lapin06/HT2018/README.md

<h1>Color Rabbit Prediction - FAURE Héloise & LEMAIRE Théo</h1>

<h4>-------------------------------------------Le lapin mentaliste qui prédit vos choix--------------------------------------------</h4>
  </p>
  
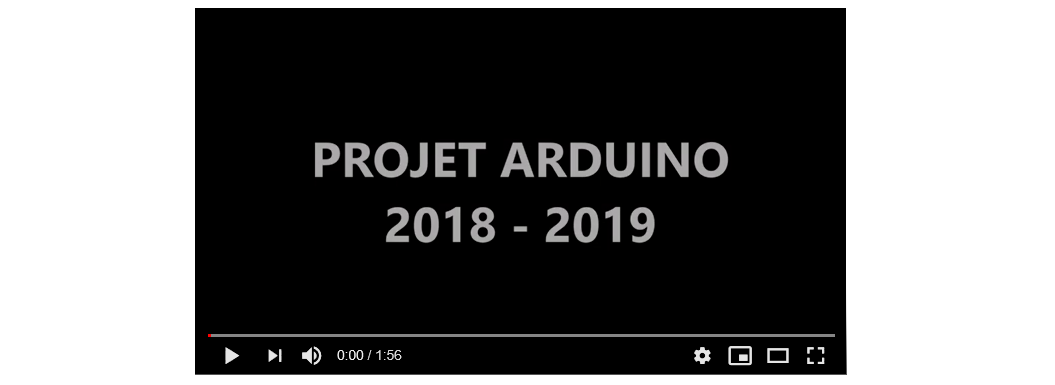
[picture p1: Ressources/video.PNG]
  
  <a href=https://www.youtube.com/watch?v=MNZIZz9GOWQ> ==================================>  LIEN VIDEO <=================================== </p> </a></p>
<p>-------------------------------------------------------Bande annonce ----------------------------------------------------------------</p>

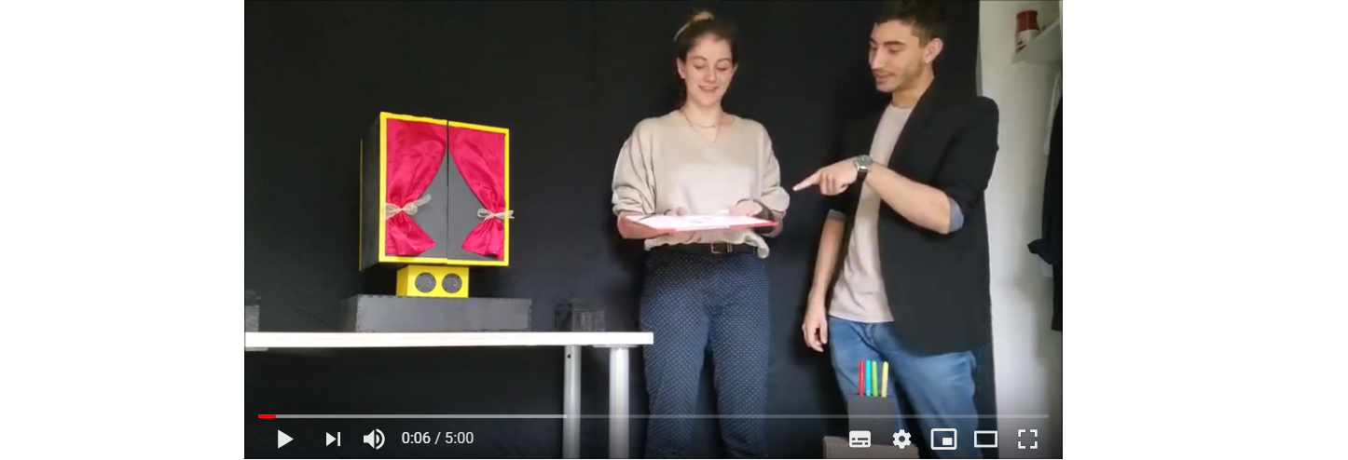
[picture p2: Ressources/Oral2.png]

<a href=https://www.youtube.com/watch?v=OcY4DatY3gI> ==================================>  LIEN VIDEO <=================================== </p> </a></p>

<p>-------------------------------------------------Démonstration en 5 minutes ---------------------------------------------------------</p>

<h3>  1. Sommaire : </h3>
<ul>
  <li><h4> Documents </h4>
    <ul><li>planning du projet: mit à jour toutes les semaines, concernant notre avancement dans le projet ( si nous avons respecté le planning)</li></ul>
    <ul><li>le cahier des charges, de notre Création Color Rabbit Prédiction</li></ul>
    <ul><li> Scripte du lapin</li></ul>
    <ul><li> Enregistrements</li></ul></li>
  
  <li><h4> Les Rapports de séances</h4>
  <ul><li>Rapport - Heloise</li></ul>
  <ul><li>Rapport - Théo </li></ul>
    <p> Dans ce répertoire vous pourrez suivre notre progression grâce au rapports de séances rédigés chacun par un des membres du binôme</p></li>
  
  <li><h4> Ressources </h4>
   <p> Dans les ressources vous pouvez avoir acces aux différents images (ou autres) qui apparaitront dans les rapports de séances </p>
    
  <li><h4> CODE </h4>
  <ul> <li>1.Boite à feutre </li></ul>
  <ul><li> 2.Boite à lapin </li></ul>
    <ul><li> 3.Test composants </li></ul>
  </li>
  </ul>
  <br/>
  
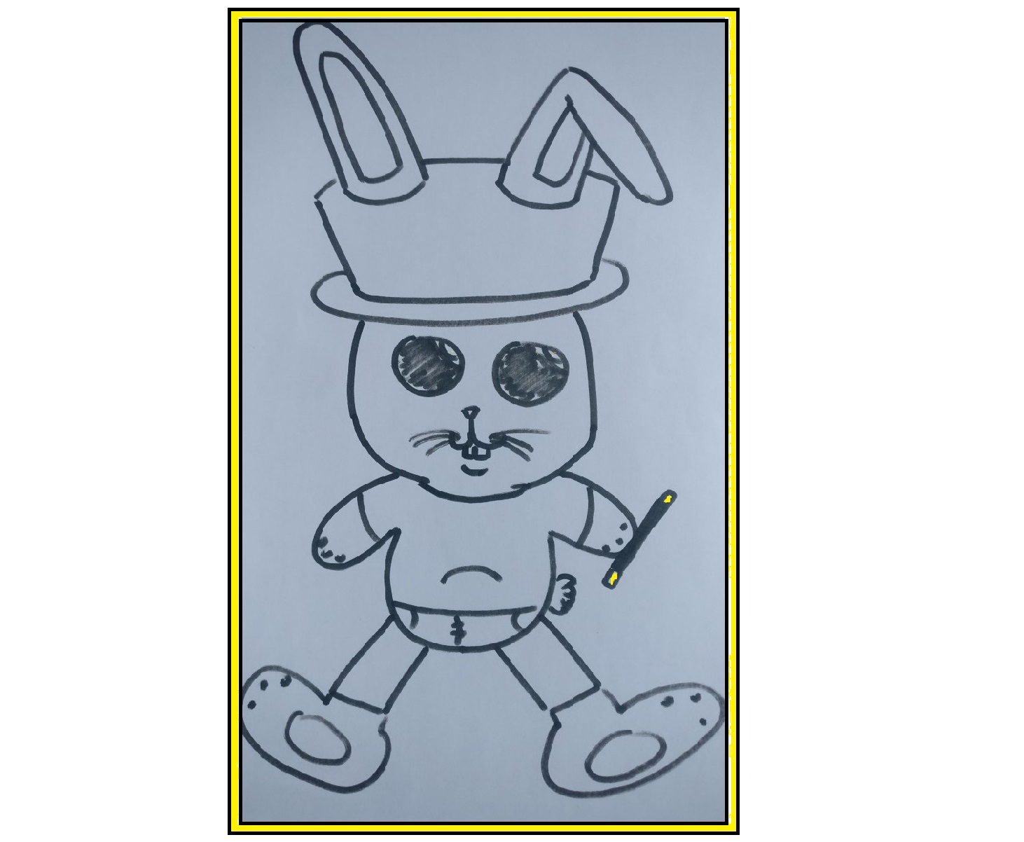
[picture p3: Ressources/20-3.jpg]
  

<h3> 2. L'histoire : </h3>
<p> Inspiré du tour original color pen prediction , proposé par la société americain murphys magic et vendu à l'échelle mondiale. Un veritable Best Seller depuis 5 ans , nous allons vous proposer ici notre version de ce tour, Le color rabbit prediction! Nous proposons ici un version ou le magicien ne fait aucune action sur le tour, tout est fait par une petite pelucche (le lapin). Ceci permetd d'avoir de nombreux avantages, permettant de transformer une prestation d'un magicien seul pour passer a un duo plein de folie. Pour d'avantage d'explication nous vous invitons a consulter notre cahier des charges </p> 
