lapin06/HT2018/Rapports de séances/Rapports - Héloise.md

<h1>Séance 1 : 10/12/18 : Début du projet</h1>
<h2> Aujourd'hui nous avons démarré notre projet qui s'intitule "Color Rabbit prediction"</h2>
 <li>
  <ul><h3> Organisation du travail </h3></ul>
     <p>Nous avons découpé les étapes du projet en fonction des séances, pour cela nous nous sommes mis d'accord pour un planning que j'ai ensuite réalisé. Cela m'a prit la moitié de la séance car il est difficile de prévoir le temps que l'on mettra pour chaque étape du code et de la construction, ce planning sera disponible dans /HT2018 </p>
 
 <ul><h3>Cahier des charges</h3></ul>
  <p>Ensuite j'ai réalisé le cahier des charges correspondant au projet, celui-ci sera aussi disponible dans le répertoire principal (temps: 1h15) </p>
  
  <ul><h3> Communication Arduino </h3></ul>
  <p>Dans la dernière demi heure j'ai commencé à faire des recherches sur comment faire parler une carte Arduino, ce qui est une grande partie de notre projet. j'ai trouvé assez rapidement le code relatif à cela, mais pour le réaliser il faut importer la librairie tolkiez, j'ai alors rencontré un problème de compilation avec cette librairie. je résoudrai surement ce problème chez moi ou la séance suivante. L'idée est la suivante: le Lapin et en fait celui qui va parler tout le long du tour ( ce tour n'a pas besoin de d'interactions avec nous pour fonctionner), cela implique qu'il devra lui même désigner quels parties colorier, il dira bonjour etc... </p>
  </li>

<h1>Séance 2 : 17/12/18 : communication arduino avec Sparkfun Voice box shield</h1>
<li>
<ul><h3> Utilisation de Sparkfun Voicebox Shield </h3>
<p> J'ai abandoné l'idée d'utiliser la librairie tolkiez.h qui est une librairie permettant d'écrire un code pour faire parler la carte Arduino avec l'aide d'un haut parleur. En effet je n'arrivais pas à résoudre les problèmes de compilation.

Je suis donc passer au Sparkfun Voicebox qui est composé d'une carte voiceBox, d'une carte arduino et d'un haut parleur. Le but étant de pouvoir faire parler notre lapin avec ce haut parleur, avec lequel on peut mettre une carte mémoire qui va pouvoir mémoriser ce que notre lapin va dire. On a donc besoin de la librairie "software serial" pour parler au SpeakJet (voiceBox). J'ai donc commencer mes recherches et j'ai pu trouver un github qui explique comment se servir de ce voicebox, accompagné d'un code. </p>

<h4> problème de compilation </h4>
<p> J'ai téléchargé le code et j'ai passé du temps à comprendre les différents points de cette voicebox ( par exemple les sorties/entrées RST, RDY,SPK), et à comprendre comment cabler tout cela(nous avions déjà en stock le matériel).
Je me suis ensuite retrouvé face à un problème de compilation de nouveau, cette fois j'ai réussi à comprendre ce problème et j'ai donc cherché une solution. PROBLEME: "narrowing conversion of '200' from 'int' to 'char' inside { }" char permet de prendre des nombres en 7bit (et permet de mettre un signe devant) or dans ma chaine de caractère j'ai des nombres en 8bit ( tous les nombres >=100) j'ai donc trouvé la solution en mettant devant char : unsigned , cela permet d'enlever le bit réservé au signe, donc char est dorénavant en 8bit et peut aller jusqu'a 255. </p>

<p> mais ce n'était pas le seul soucis... en effet je n'arrivais toujours pas à compiler mon programme, alors que sur l'ordinateur de mon binôme , la compilation se faisait sans erreur. j'ai pu résoudre ce problème en téléchargeant la version la plus récente d'Arduino. j'ai testé mon programme en faisant dire à la carte " hello " . Cela fonctionne! </p>

<p> Tout ce temps passé à essayer de résoudre les problèmes de compilation et à re-télécharger Arduino m'a fait perdre un temps précieux. Cependant aillant réussi à faire fonctionner le haut parleur, je pourrai rattraper tout ce temps pendant les vacances en écrivant le code pour faire parler arduino ( un code qu'il faut travailler car chaque lettre ou syllabe est codé d'une manière spéciale, et qui plus est, en anglais) . </p>

<h4> je vous invite à aller voir la vidéo où Spark nous dit bonjour, en clickant sur le lien suivant: <a href="https://www.youtube.com/watch?v=zQq6gc-LgdA"/> Sparkfun hello </h4> </li>

<h1>Travail 1 (hors Séances) : 21/12/18 : Sparkfun et boite des feutres</h1>
<li>
 <ul><h3> Approndissement de la librairie Sparkfun </h3></ul>
 <p> Aujourd'hui je me suis un peu plus penché sur la librairie Sparkfun pour pouvoir comprendre vraiment comment cela fonctionne et pour commencer à coder des phrases en anglais par moi même. Je me suis confrontée à plusieurs soucis, dont le plus gros et que, ce que dis notre carte Arduino et particulèrement inaudible quand on ne connait pas la phrase en anglais... Il faut donc que je cherche si Sparkfun permet aussi de modifier la voix pour éviter cette voix robotique trop métalisée. Le deuxième soucis et que le code permet de coder des prononciations et pas des syllabes, j'ai passé donc énormément de temps pour simplement lui faire dire "Rabbit" (=lapin) car il fallait trouver le code relatif aux lettres ou sons, puis ensuite trouver le code chiffré correspondant. En aillant écrite toutes les phrases que notre arduino doit dire, on s'est rendu compte que cela aller me prendre un temps considérable pour tout coder et d'autant plus que cela sera à peine compréhensible. On se retrouve donc face à une impasse. 
Nous avons pensé à une possibilité et nous demanderont la faisabilité de celle-ci par mail:
   Enregistrer nous même nos voix car nous avons la possiblité de mettre une carte mémoire sur Sparkfun. </p>

 <ul><h3> Schema de la boite de feutre </h3></ul>  
 <p> Aujourd'hui nous avons pris la décision de faire la maquette de la boite de feutre étant donné que le code des capteurs était fait.
 Nous avons donc réalisé deux schémas car nous ne savions pas si nous devions faire une boite ronde ou carré ( l'avantage de la boite ronde était que celle-ci faisait plus naturellement pot de feutre). Vous pouvez voir les schemas ci-dessous avec les dimensions prises:
 
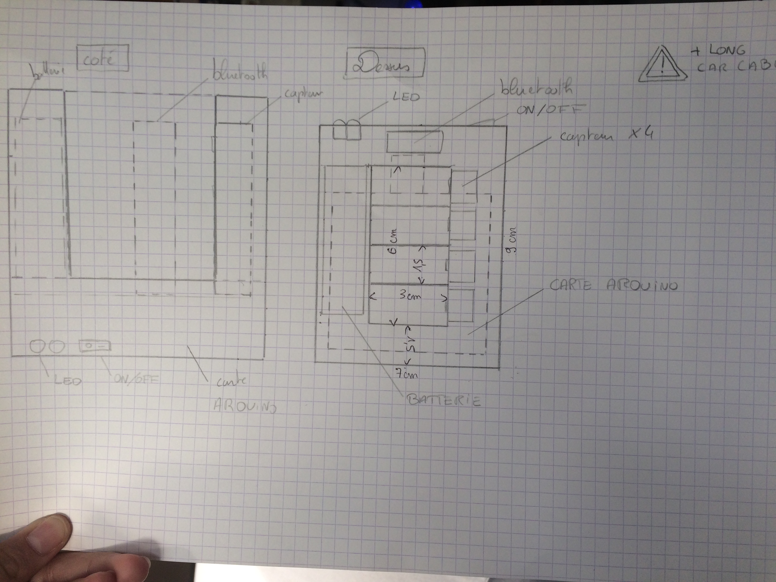
[picture p32: Ressources/schema_boite_feutre_rectangle.JPG]
 
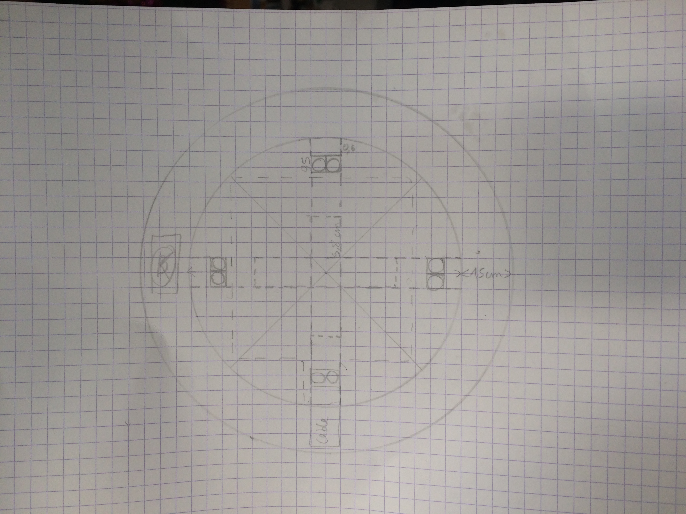
[picture p33: Ressources/schema_boite_feutre_ronde.JPG]
 
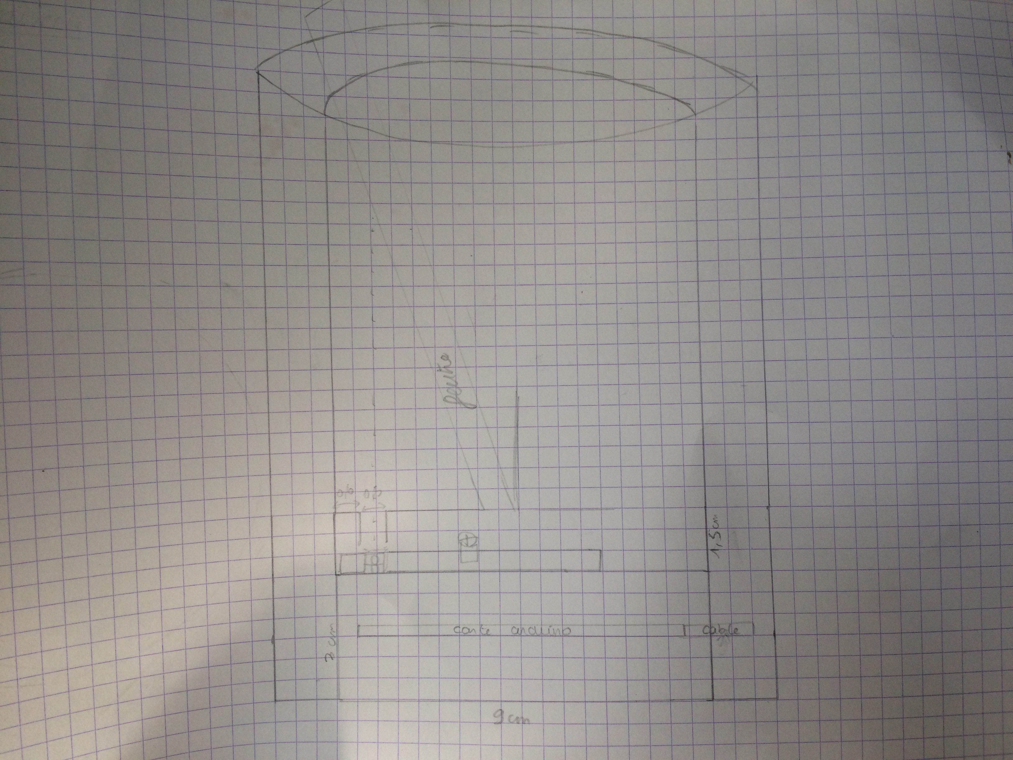
[picture p34: Ressources/schema_boite_feutre_ronde_2.JPG]
  </p>
 
 <ul><h3> fabrication de la maquette de la boite de feutre </h3></ul> 
 <p> Nous nous sommes renseigné hier pour savoir où réaliser notre maquette, par chance le gérant de l'atelier avait un créneau pour nous aujourd'hui. Nous sommes donc allé aux Templiers à l'atelier et nous avons demandé conseil sur la forme de la boite. Le spécialiste nous a conseillé la boite rectangle car cela serait beaucoup plus pratique et réalisable. Il nous a également montré comment créer notre patron grâce au logiciel "LibreCad" où au logiciel qui crée directement une boite avec les dimensions que l'on veut, de plus, les pièces sont découpées de telle sorte que l'on peut les assembler directement comme un puzzle.  Nous avons donc utilisé ce deuxième logiciel pour créer notre patron avec les bonnes mesures. Une vidéo du découpage nos pièces avec le laser est disponible sur notre chaine youtube. La boite est prète. Vous pouvez la voir ci-dessous:
 
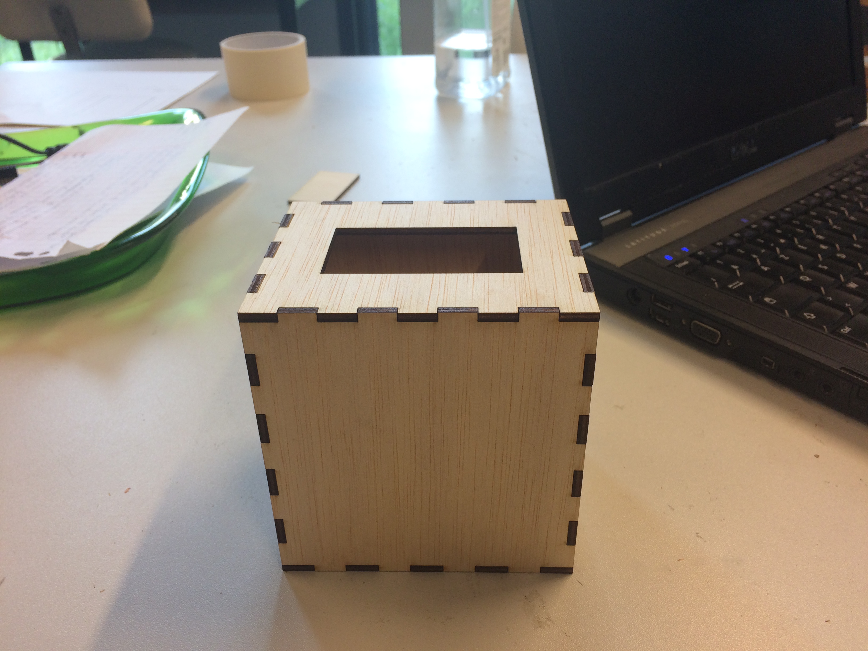
[picture p35: Ressources/boite_feutre_1.JPG]
 
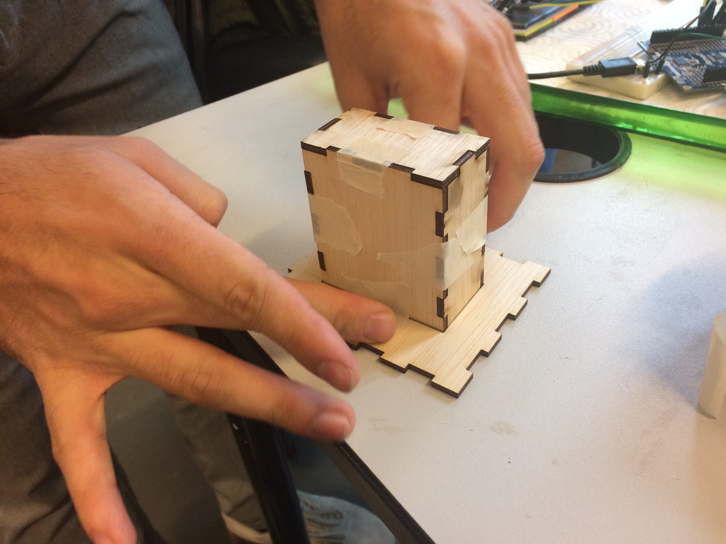
[picture p36: Ressources/boite_feutre_2.JPG]
  </p>
 
 <ul><h3> Essai avec les bluetooth </h3></ul> 
 <p> Nous avons essayé de connecter les bluetooth entre eux, mais nous n'avons pas réussi à brancher le bluetooth "maitre" ( les fils ne rentraient pas) donc nous verrons la prochaine fois si on trouve une autre solution. 
 Pour ma part, je vais avancer sur le code des phrases en anglais dans le cas où nous n'avons pas d'autres solutions pour la communication </p>
  </li>
<h1>Séance 3 : 07/01/19 : Bluetooth et boite feutre</h1>
<li>
 <ul><h3> Connexion des bluetooth </h3></ul>
 <p> Lors de cette séance nous avons essayé de connecter les bluetooths entre eux ( En forçant les fils rentrent ). Mon binôme s'est occupé du bluetooth maitre quant à moi je m'occupais d'initiliser l'esclave, j'ai eu des problèmes de téléversements, les commandes AT ne répondaient pas. Le problème a été résolu petit à petit, il fallait résoudre quelques soucis comme la vitesse de communication entre l'ordinateur et la carte qui devait être initialisée dans un ordre précis. Nous avons pu trouver l'esclave avec le maitre, le maitre s'appareillait bien mais l'esclave non. On se verra dans la semaine pour résoudre ce problème. </p>
 
 <ul><h3> Boite feutre et capteurs </h3></ul>
 <p> Après avoir fait la boite des feutres, j'ai réfléchis à un moyen de placer les capteurs pour qu'il y ai le moins d'interférences possibles. A deux nous avons trouvé la solution de les mette "débout" le long de la boite. J'ai donc pris les mésures nécessaires. J'ai également indiqué l'endroit ou nous devront percer la boite afin de faire tenir les capteurs. Vous pouvez voir le résultats ci-dessous:
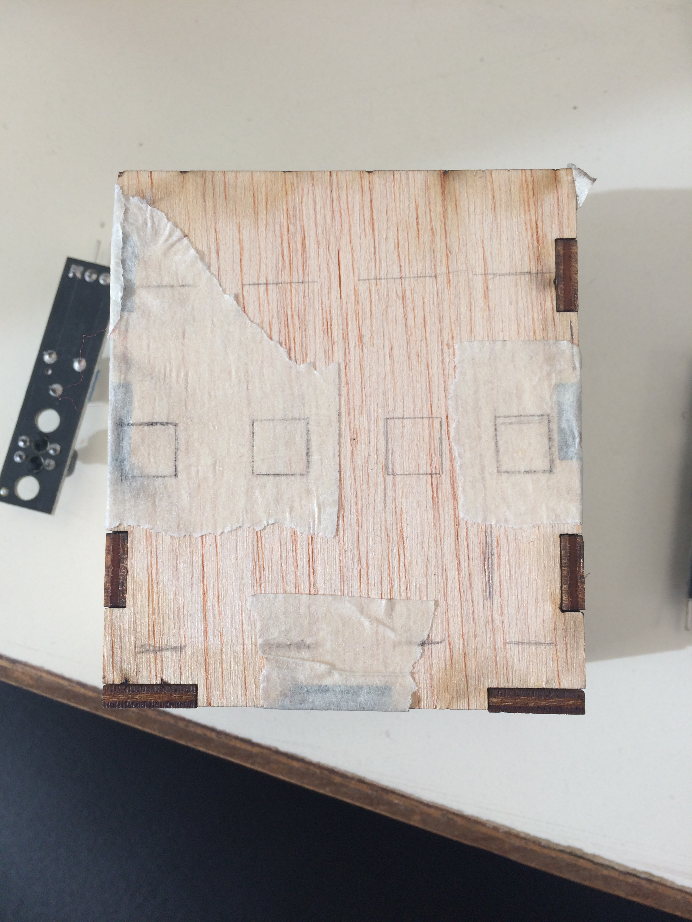
[picture p37: Ressources/dessin_capteurs_boite.jpg.JPG]
  
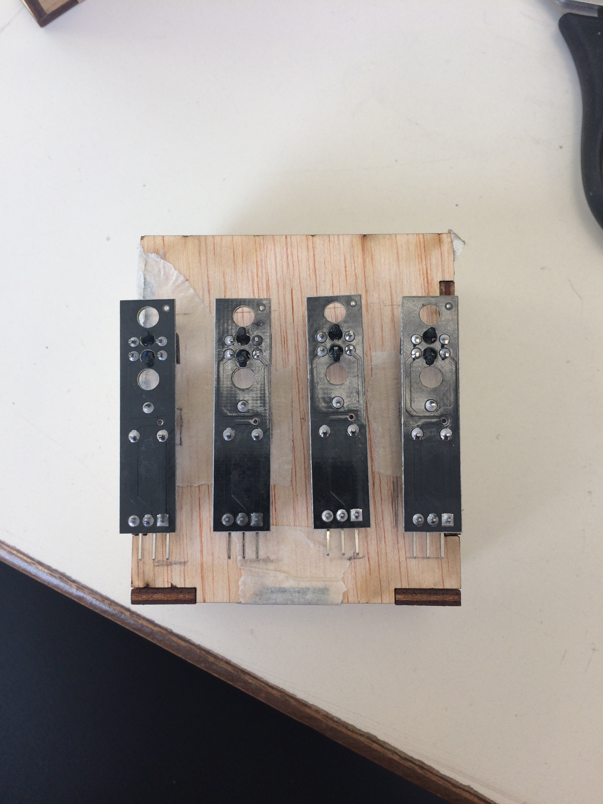
[picture p38: Ressources/position_capteurs.jpg.JPG]
   </p>
 
 <p> Avant la prochaine séance, nous voulons apparailler les bluetooth correctement ainsi que percer la boite pour mettres les capteurs et les feutres. De mon coté je commencerai le code du servomoteur.
Nous attendons encore le module de communication pour pouvoir enregistrer nos voix.</p> </li>

<h1>Séance 4 : 14/01/19 : finalisation de la boite feutre</h1>
<li>
 <ul><h3> Travail hors séances </h3></ul>
 <h4> boite feutre </h4>
 <p> Nous avons fini la boite de feutre! Etape par étape nous avons finalisé cette boite en commençant par percer les fameux trous pour les capteurs. Ensuite nous avons positionné les capteurs et fait plusieurs test pour voir si tout allait bien. L'étape suivante consistée à réaliser des compartiments dans la boite afin que chaque feutre ai son propre espace pour ne pas que les capteurs interfèrent ou que les feutres aillent sur le mauvais capteur. Afin de rendre la boite plus naturelle nous avons fait un trou dans la boite pour pouvoir mettre une règle dedans. J'ai peint la boite de feutre en noir. Nous avons ensuite réalisé notre propre studio d'enregistrement pour le lapin. Un peu de miel et de lait et hop c'est parti pour prendre une voix aigue ( notre but était de le rendre enfantin et narcissique). 
Pour finir, Mon binome travaillait sur la connexion des deux bluetooth car il y avait toujours un problème avec le blutooth esclave pendant que je travaillais sur la boite du lapin. 
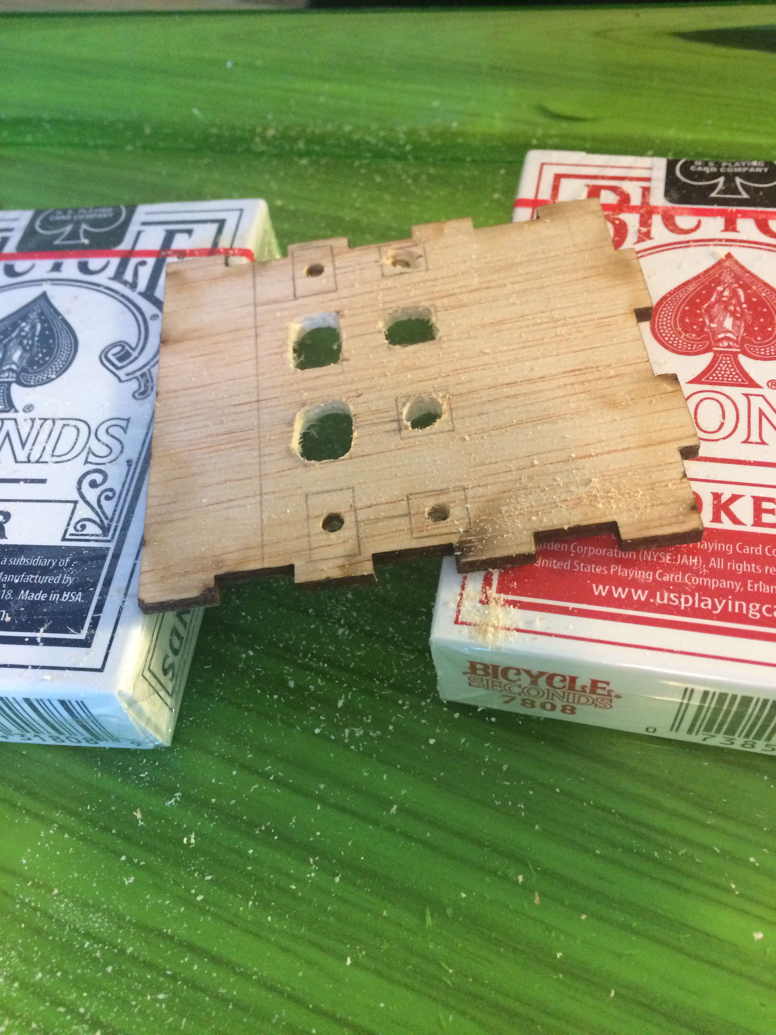
[picture p39: Ressources/perçage.JPG]
  
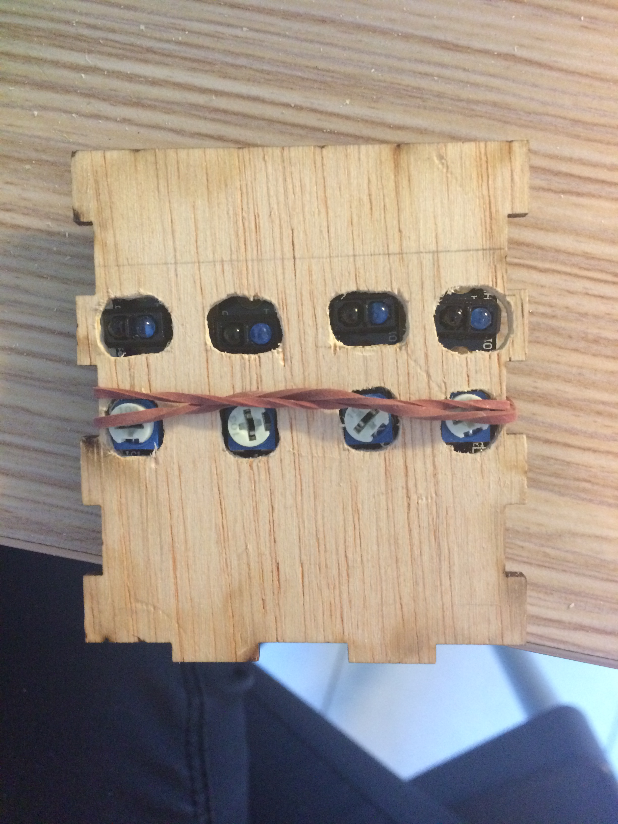
[picture p40: Ressources/capteurs_trous.JPG]
   </p>
 
 <h4> boite du lapin et servomoteur </h4>
 <p> J'ai donc réfléchis au design de la boite du lapin car l'objectif et simple: Lorsque c'est la fin du tour le servomoteur, positionné à l'interieur en haut de la boite du lapin, qui relie avec un crochet les deux parties de la boite, tourne pour enlever le crochet et les deux cotés de la boite tombent pour laisser place au lapin. Le code du servomoteur etait plutot simple car nous lui demandons seulement une rotation de environ 9 degrès ( les mesures seront plus précises plus tard ). Vous pouvez donc voir le code ci-dessous:
#include<Servo.h>;
Servo servo;

void setup(){
  servo.attach(2,544,2400);
}
void loop (){
 servo.write(0);
  delay(2000);
  servo.write(180);
  delay(2000);
 }
  ce code sera inséré au code des capteurs. Il fallait cependant que je réfléchisse à la répartition du poid car les deux cotés de la boite doivent tomber vers l'extérieur. plusieurs otpions : soit des poids apparant en dehors de la boite pour forcer les cotés à tomber, mais cela ferait pression sur le servomoteur et donc cette idée est secondaire. La deuxième option est de jouer sur le design de la boite pour faire basculer automatiquement les deux cotés. Avec du papier, j'ai donc fait un premier essai de cette boite. Le premier essai était plutot concluant. 
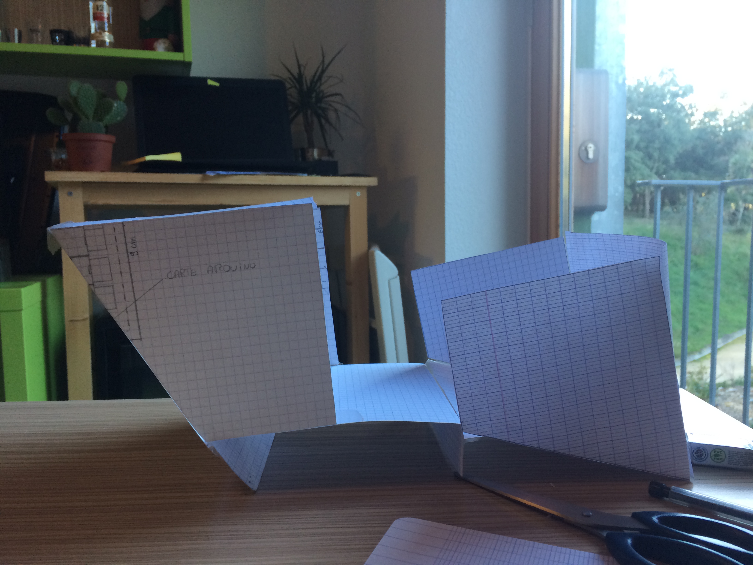
[picture p41: Ressources/boite_lapin.JPG]
   </p>
  
  <ul><h3> Durant la séance </h3></ul>
  <h4> finalisation boite et blutooth </h4>
  <p> Je me suis occupée de finaliser la boite feutres en réalisant les derniers collages ( les compartiments). Ensuite nous avons réussi à mettre en relation les deux bluetooth, en testant le programme des capteurs avec la boite et les bluetooth, tout fonctionne. </p>
  <h4> Communication lapin </h4>
  <p> Ca y est notre commande du module serial MP3 permettant de jouer des musiques avec une carte SD reliée à l'arduino est arrivé! JE peux enfin terminer la partie comminication qui est un élément clé du tour. J'ai pu trouver chez moi une mini carte SD ainsi qu'un adaptateur. Il ne manque plus que le code. En réalisant des recherches j'ai trouvé plusieurs tuto nous expliquant comment faire marcher ce module.
voici le cablage:
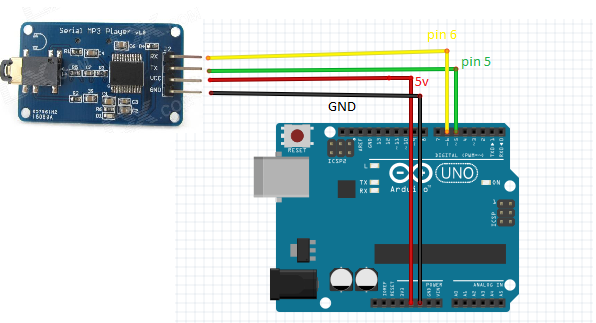
[picture p42: Ressources/schema_MP3.png]
 
Le premier code trouvé est plutot compliqué à comprendre mais je ne le laisse pas de coté vous pouvez le voir à l'addresse suivante:
 
<a href="https://www.hackster.io/javier-munoz-saez/arduino-mp3-player-catalex-2effef">CODE 1</a>
 En allant sur youtube, j'ai trouvé un tuto plutot simple pour faire fonctionner le module, j'ai donc suivis les étapes à la lettre, écris le code relatif... mais cela ne fonctionne pas! Je ne comprends pas d'ou l'erreur provient. Il faut que je test d'autre code pour un trouver un qui fonctionne et que je comprends bien. C'est donc la dessus que je passerai mes prochains temps libres hors séances car il faut absolument que cela fonctionne. je vous met en lien la vidéo que j'ai trouvé avec le code et les étapes à suivre: 
<a href="https://www.youtube.com/watch?v=rdKk-1MRMqY">VIDEO CODE</a> </p>

<h1>Travail Hors séances : 31/01/19 : Communication et lapin </h1>
<li>
 <ul><h3> Communication Serial MP3 </h3></ul>
 <p> Ca y est notre lapin peut enfin parler ! Maintenant qu"il peut parler il ne s'arretera pas de si tôt! J'ai réussi à faire fonctionner le programme ( le premier que j'avais annoncé plus haut ). Sûrement un problème de branchement ou simplement que je n'avais pas bien compris le code. La démonstartion en vidéo est disponible sur notre chaine youtube à l'adresse suivante :
  <a href="https://www.youtube.com/watch?v=jJuvhTnKgMg"> CountingStars </a>.
  <br>
  Le seul soucis qu'il fallait régler et que le programme ne pouvait lire que seulement une chanson à la fois, et nous , nous avons besoin de pouvoir lire plusieurs fichiers audios en fonction de ce qu'il choisit. "En fonction de" j'ai donc résolu ce problème en traduisant cette phrase par des boucles " if ". Si le moniteur serie lit " 1" alors il va jouer telle chanson, si le moniteur lit "2" il jouera alors une autre chanson. J'ai également brancher des hauts parleurs et avec un modifieur de watt pour pouvoir bien entendre sans les écouteurs. Tout est presque pret. Prochaine étape c'est d'incorporer le code, donc les enregistrements audio dans le code de la carte du lapin. 
  Le bluetooth esclave recevra et lira une information, par exemple OKV ( donc choix du feutre vert ) et donc dans la boucle " if (OKV) " on lira l'enregitrement audio associé. je n'ai pas les enregristrements audio (d'ailleurs on les garde en surprise donc pas de démonstration de voix!) donc je vais me contenter d'ajouter le code sans ceci pour l'instant.
  Tout prend forme petit à petit... </p>
 <br>
 <ul><h3> Notre assistant le lapin est prêt pour son show ! </h3></ul>
 <p> ABRACADABRA et hop notre vedette est enfin parmi nous ! J'ai donc fais les magasins pour acheter à notre lapin sa tenue de scène très spéciale... Après avoir fait les essayages en live, celui-ci était plutôt content de ses habits ! Chapeau ok.. t-shirt ok.. pantalon ok.. chaussettes?? NON !! impossible de trouver en magasin les chaussettes qu'il voulait ... VERTES en même temps, qu'elle idée de lui mettre en tête d'avoir des chaussettes vertes c'est cool. Ce n'était pas très malin de notre part. Je ne voulais pas le décevoir alors j'ai décidé d'acheter un tissu vert et des coudres moi-même ! le pauvre il ne s'imagine pas ce qui lui attend...</p>
  <br>
  <p>J'ai donc passé ma journée à retoucher ses vétements car oui il fallait pratiquemet tous les retoucher, monsieur lapin est très exigeant et a une morphologie bien particulière... c'est parti pour faire des trous dans son bonnet pour faire passer ses oreilles, un trou dans le pantalon pour faire passer sa petite queue toute ronde, et surtout couper les jambes du pantalon !! Mais ce pantalon n'était pas une mince affaire car il s'éffiloche quand on le coupe.. il a donc fallu que je retrousse mes manches et que je m'applique davantage pour lui faire des ourlets! Vous pouvez voir la vidéo avec/sans ourlets sur notre chaine youtube à l'adresse suivante: <a href="https://www.youtube.com/watch?v=7n4_YJZbMgk&feature=youtu.be">Ourlets en video </a> pour comprendre pourquoi cela a était nécessaire. 
<br>
sur la photo ci-dessous, à droite SANS ourlets à gauche AVEC: 
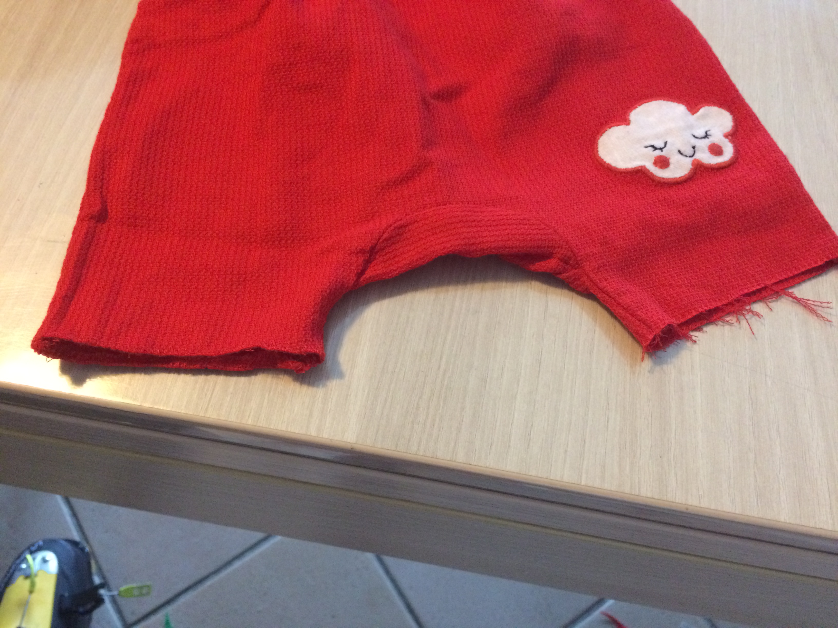
[picture p43: Ressources/ourlets.JPG]
 </p>
  <br> 
  <p>C'est à peine si j'ose vous parler de mes talents de couturière si je vous montre les chaussettes que j'ai fais. Mais l'essentiel est que les chaussettes sont à sa taille et qu'elles lui plaisent. ouf!  
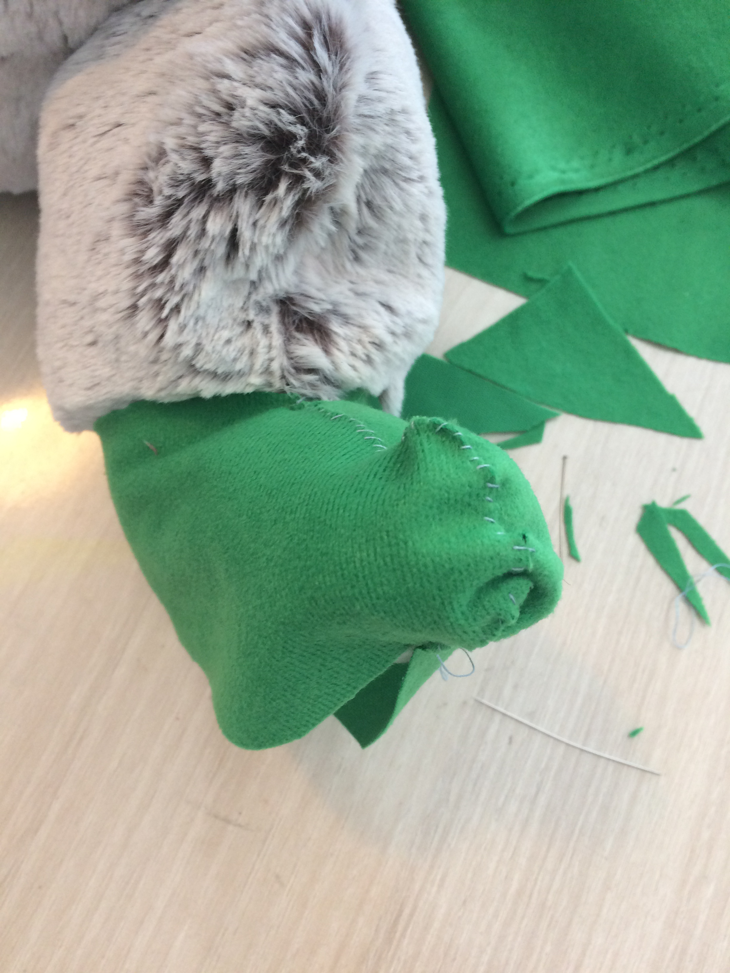
[picture p44: Ressources/chaussettes_coutures.JPG]
   
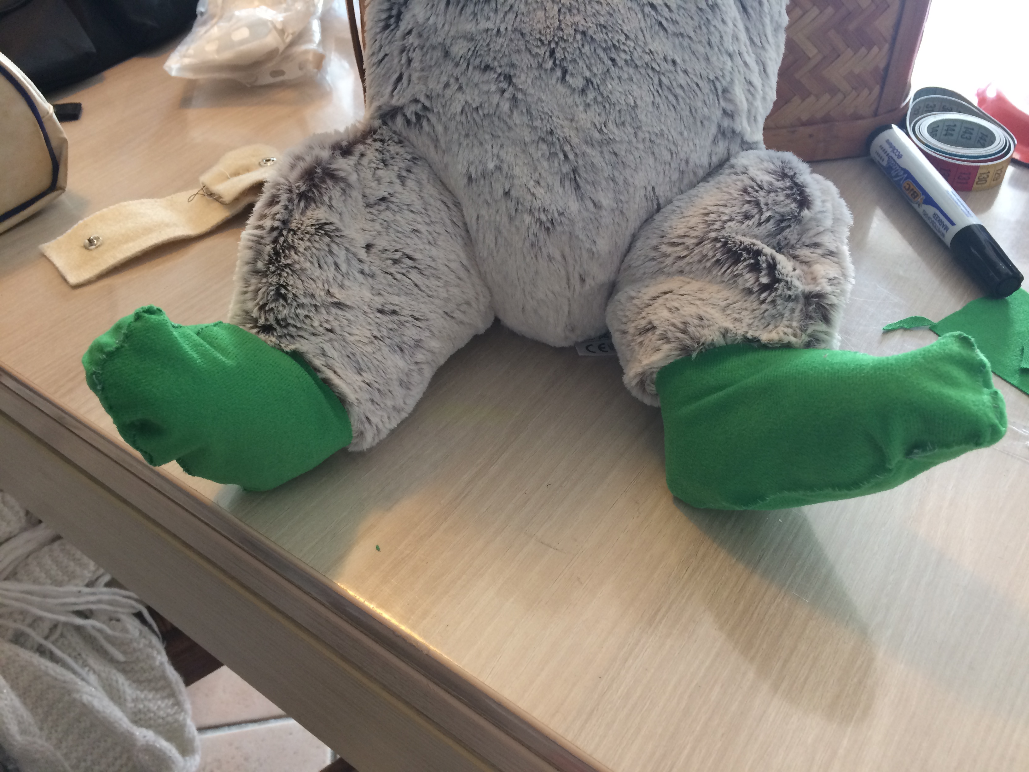
[picture p45: Ressources/Chaussettes.JPG]
    </p>
 <br>
 <p> Ca y est notre vedette est prète et elle hésite pas à prendre la pause... 
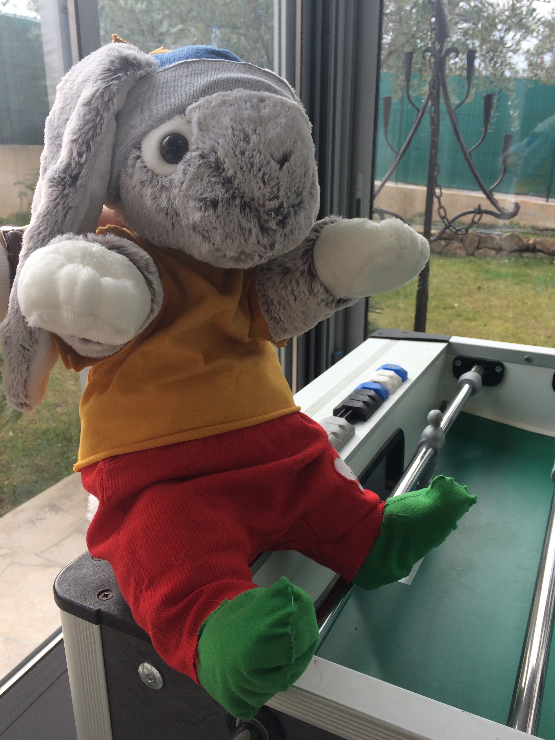
[picture p46: Ressources/face.JPG]
  
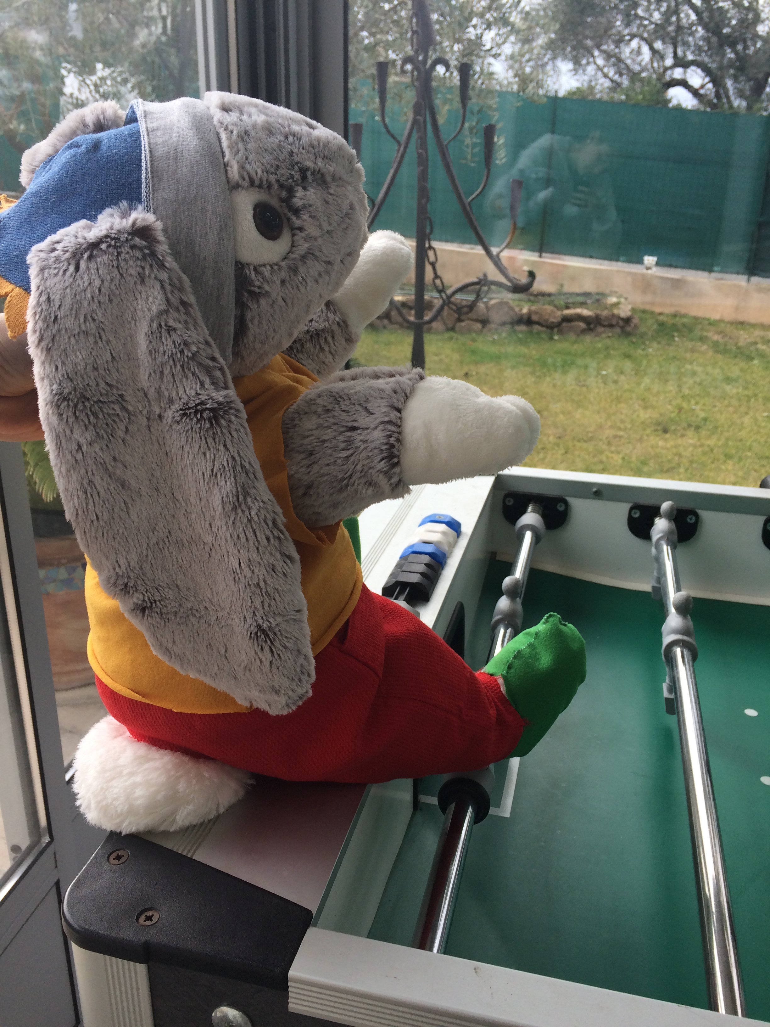
[picture p47: Ressources/profil.JPG]
   </p>
<br>
<h1> Séance 5: 04/02/19 : finalisation communication (enregistrements dans le code) </h1>
<p> Aujourd'hui j'ai finalisé le code en y ajoutant tous les enregistrements en commençant par les récupérer puis les convertir en MP3. Ensuite je les ai ajouté au code.
 <br>
 Pour aider à comprendre la suite... Dans le code principal du Serial MP3 il y a plein d'options de lecture, par exemple "play_with_folder", le mode de lecture et la sélection des audios diffèrent donc en fonction de ce que l'on prend comme option. Il y a des options qui permettent la lecture d'un fichier audio: "<strong>CMD_PLAY_WITHVOLUME</strong>" et "<strong>"CMD_PLAY_WITHFOLDER</strong>. le premier permet de lire les audios dans l'ordre où ils sont dans la carte SD donc si on écrit 01 il va lire le premier audio, 02 le deuxième etc... sans prendre en compte le numéro de l'audio; la deuxième option ermet de choisir le dossier et dans le dossier l'audio ( en mettant 0x0F0101 , il lit l'audio 001xxx.mp3 qui se trouve dans le dossier 01 ). 
 <br>
 Donc au tout début j'ai mis les enregistrements dans l'ordre et j'ai utilisé l'option 1 , sauf que les enregistrements n'étaient pas tout a fait dans l'ordre et de plus il ne peut pas lire les nombres, seulement les chiffes ( cela s'arretait à 009) , par conséquence le 16eme audio ( noté 016 ) ne pouvait pas être lu et la carte comprenait 001 donc lisait le premier enregistrement. J'ai donc essayé plusieurs choses, plusieurs changements avec cette option ( modification du nom du fichier, modification de la commande : 0x0F***) mais cela ne focntionnait toujours pas. Ensuite je suis passé à l'option numéro 2 avec une seul dossier dans lequel j'ai mis les neufs premiers audios, et un autre dossier ou j'ai mis le reste des audios. l'arduino ne comprennait toujours pas la commande avec des nombres. 
 <br> En me creusant un peu plus la tête, j'ai finis par trouver une solution en combiant les deux otpions: un dossier "01" avec les neufs premiers audios ( 001,002,...,009) et en dehors du dossier les enregistrements de 010 à 016 . J'ai donc utilisé l'option 2 "lire le fichier" pour les neufs premiers audio et pour les autres enregistrements, j'ai utilisé la lecture des fichiers dans l'ordre. EUREKA cela fonctionne! Vous pouvez donc voir le code principal des enregistrements en clickant sur ce lien: <a href = ""> MP3_CODE<a/>.
 <br> 
 le code final est le code du lapin modifié, vous pouvez le voir en clickant sur le lien: <a href ="https://github.com/lapin06/HT2018/blob/master/CODE/2-LAPIN.ino" >Lapin_CODE </a>
<br>
 <h1> Séance 6: 11/02/19 : jumulage des codes avec bluetooth - Boite lapin</h1>
 <li>
 <ul><h3> Jumulage des codes </h3></ul>
  <p> Ca y est comme les deux codes fonctionnent individuelement on peut les faire intéragir grâce aux bluetooths. Pendant cette séance on a tout mis en place pour que le code contenant les audios et le code des capteurs soient en harmonie. Après de nombreux essais pour connecter les bluetooth nous avons mis en relation les codes pour que, dès qu'une lettre est envoyée, le code du lapin sache quel audio jouer. Cela est traduis en code mot à mot: "si le bluetooth lit x lettre, alors il joue tel audio". Nous avons donc retravailler un peu les codes chacun de notre coté pour que cela fonctionne bien. A la fin de la séance nous avons réussi à jouer l'audio correspondant à la lettre lu par le bluetooth. </p>
  <br>
  <li>
 <ul><h3> boite lapin (hors séance)</h3></ul>
   <p> Nous sommes allé au FABLAB pour confectionner la boite du lapin. Comme les dimensions de certains cotés étaient plus grand que la planche de la découpeuse laser nous avons mit du temps à couper les parties et les remettre ensemble. Nous avons eu seulement le temps de faire le socle de la boite ( la où va se trouver la carte arduino avec tous les fils et la led qui sert d'indication de démarrage du code). <p>
   <br>
   <p>Nous retournerons au FABLAB jeudi pour faire les deux autres boites qui confectionne la boite du lapin. En effet celuici n'aura pas la seule est unique boite que nous avons modélisé avec du papier. Pour question d'estétisme la boite du lapin est dévisé en trois parties: le socle, l'estrade et la boite contenant le lapin. Tout cela car lorsque les cotés de la boite tomberont, pour pouvoir voir le lapin il faut que les cotés soient plus bas que le lapin ( d'où l'estrade). Les cotés de la boite du lapin vont simplement tenir sur l'estrade avec des attaches et le servo moteur tiendra les deux parties. </p>
<br>
   <h1> Travail hors séance : 14/02/19 : fin jumulage des codes avec bluetooth - 2 dernières Boites du lapin </h1>
   <p> Aujourd'hui nous sommes donc allé au FABLAB pour finaliser la boite du lapin ( donc l'estrade et la boite lapin). Nous avons pensé à faire des trous dans l'estrade pour pouvoir mettre les hauts parleurs. Vous pouvez donc voir le résultat ci-dessous: </p>
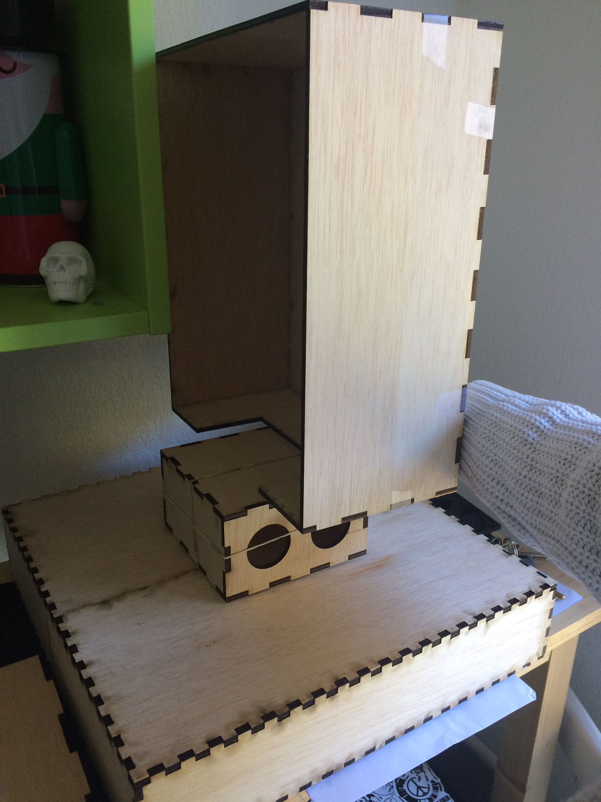
[picture p48: Ressources/boites_lapin.JPG]
    </p>
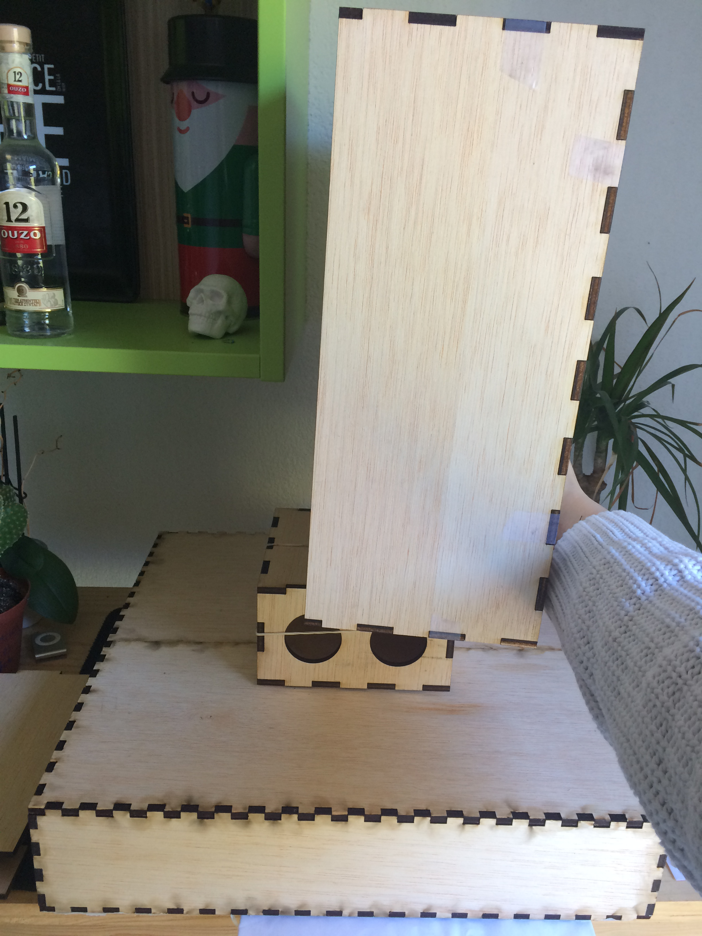
[picture p49: Ressources/boite_lapin_face.JPG]
   </p>
 <br>
 <p> Nous avons également fini les jumulages des codes ( car il fallait changer les lettres que l'on envoie, bien tout réorganiser et surtout tout essayer pour voir si TOUS les cas fonctionnent. En effet tout fonctionne! J'ai donc de mon coté ajouté le servo moteur, une petite musique de fin lorsque le lapin apparait ( on vous garde la surprise ! ) et une led qui clignote à deux secondes d'intervalle des lorsqu'on rentre dans la boucle du bluetooth ( while blueT aivailable ) Je vous invite à aller voir le code final du lapin à l'adresse suivante : <a href ="https://github.com/lapin06/HT2018/blob/master/CODE/2-LAPIN.ino" >Lapin_CODE_final </a> </p>
 <br>
 <h3> Ce qu'il reste à faire pendant les vacances : </h3>
 <ol>
  <li> Faire les trous dans les boites du lapin pour les relier et pour faire passer les fils </li>
  <li> Coller les parois de la boite du lapin </li>
  <li> Peindre la boite </li>
  <li> Installer le servomoteur ( choisir le bon emplacement, bien le fixer, le protéger, trouver un crochet et une boucle pour tenir les extrémités de la boite du haut etc...)
  <li> Trouver des poids pour aider la boite à basculer </li>
  <li> reprendre certaine parties du code des capteurs </li>
 </ol>
 <br>
 <h1> Séance 7: 25/02/19 : boite lapin et servomoteur -</h1>
 <li>
 <ul><h3> Boite lapin </h3></ul>
  <p> Notre boite pour le lapin est terminée. Nous ne pouvions pas réaliser les finitions de la boite ensemble cette semaien car mon binôme habite à Toulon! Nous avons donc décidé de le laisser terminer la boite ( meme si je devais le faire comme indiqué dans le planning ) cependant il m'était impossible de la transporter sur ma moto... Il a donc pu finir de tout coller, d'assembler, de fixer certaines parties et de la peindre. Cependant il lui manquait certain composant pour les bonnes mesures ( amplificateurs watt, servomoteur et enceintes ) j'ai donc du lui faire des dessins avec les bonnes mesures pour qu'il puisse avoir les bonnes dimensions de perçage comme je vous le monte ci-dessous: 
   <br> 
   Aujourd'hui nous avons fixé le cerveau moteur et fixé la vis dans la boite du lapin. J'ai vérifié si tous les composants fonctionnaient et j'ai réfléchis à un disposition dans la boite. Il reste donc à remplir la boite du lapin et tout fixer à l'intérieur.
   Je dois également trouver de la mousse pour ralentir la chute des deux cotés de la boite car celle-ci pourrait l'endommager. </p>
  <br>
  <h3> Servomoteur </h3>
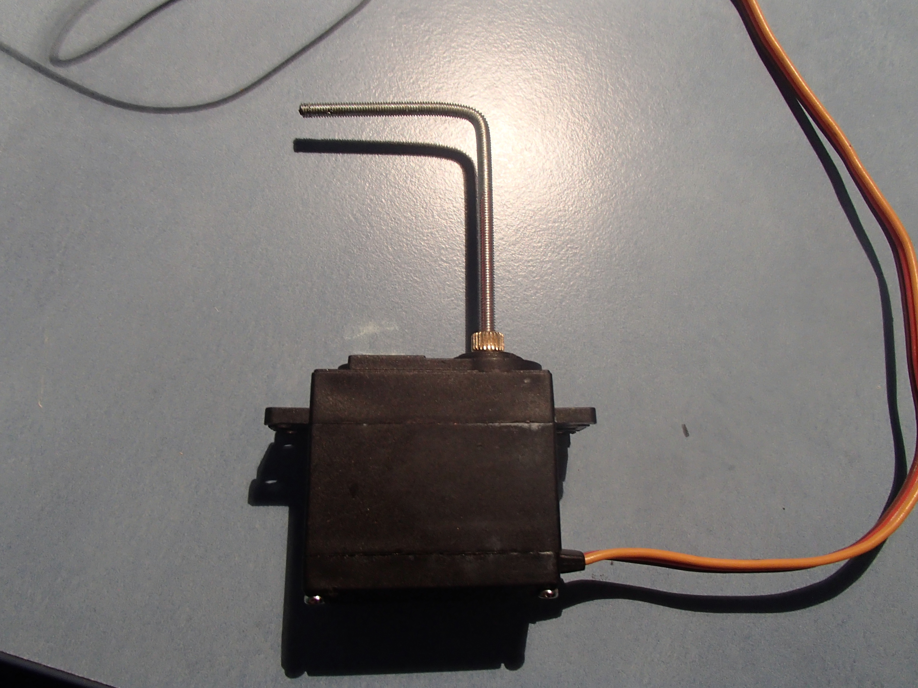
[picture p50: Ressources/crochet.JPG]
  <p> Pendant les vacances je me suis chargée de trouver une vis qui rentre dans le cerveua moteur, une vis avec un pas de 3mm. Ces vis sont généralement utilisées dans les ordinateurs et il est très difficiles d'en trouver dans des magasins normaux de bricolage en prenant en compte que cette vis doit etre tordue pour faire office de crochet. Je susi donc allé à Briconaute espérant trouver quelque chose qui s'apparente à un crochet. Comme je l'avais pensé, je n'ai pas trouvé de telles vis. J'ai cependant trouvé une solution en voyant qu'ils avaient de longue tige de métal avec un pas de vis de 3mm. J'ai acheté cette tige pour la couper et ensuite la tordre pour faire un crochet. Cela fonctionne très bien ! <p>
  <br>
  Aujourd'hui j'ai travaillé sur la rotation du servomoteur pour qu'il se détache de la vis et laisse tomber la boite. Il faut cependant pouvoir le faire tourner quand on le veut pour avoir accès à la boite et aussi pour pouvoir refermer et ouvrir quand on le veut. J'ai donc repris le code bouton_led où on mémorise l'état du bouton qui fonctionne dèslors comme un interruteur normal. EN m'espirant du code que l'on avait donc déjà écris, j'ai codé en fonction du servomoteur, j'ai laissé la led pour pouvoir comparer et éviter de trop chercher d'ou proviennent les erreurs. j'ai eu un petit soucis pendant un moment , en effet, le servomoteur ne peut pas faire un angle de 800 degrès... Néanmoins j'ai corrigé cette erreur, et cela fonctionne donc. 
  <br>
  Le code juste ici <a href ="https://github.com/lapin06/HT2018/blob/master/CODE/Bouton_Servomoteur.ino" >Bouton_Servo_CODE </a> 
  <br>
  Je vous invite à jeter un oeil à la vidéo en clickant sur le lien : <a href ="https://www.youtube.com/watch?v=Ne8aIHIhjrA">Servomoteur_bouton </a> </p>
  Je vous mets également en image les deux états du servomoteur et de la led: 
  
  
  <br>
<h1> Séance 8: 04/03/19 : finitions</h1>
 <li>
 Lors de cette séance nous avons fait les finitions de la boite du lapin, en fixant correctement le servomoteur, j'ai fais les soudures pour le bouton permettant d'orienter le servomoteur, ainsi que pour la led qui indique le bon démarrage du code. Nous cherchions toujours une solution pour retenir les deux parties de la boite quand elles tombent car elles tombent à une trop grande vitesse et donc cela risque de casser. Nous avons trouvé la solution de mettre des éponges ( pour la mousse ) au niveau des attaches mais cela ne ralentissait pas assez les parties. Lundi nous avons pensé à une autre solution : prendre deux petits rectangles en carton avec de la mousse dessus pour les mettre de chaque coté des parties pour qu'elles tombent dessus. Cela fonctionne assez bien. Nous sommes plutot satisfait. Jeudi nous essayerons et filmerons tout le tour en entier.
