lapin06/HT2018/Ressources/11-1.jpg

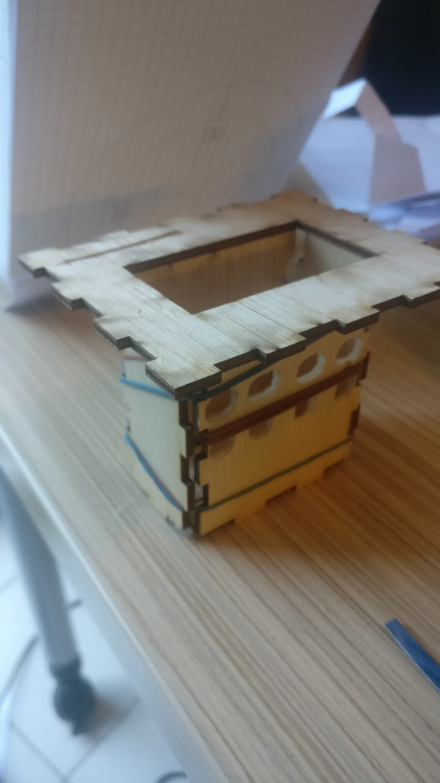
Ressources/11-1.jpg
