lapin06/HT2018/Ressources/11-2.jpg

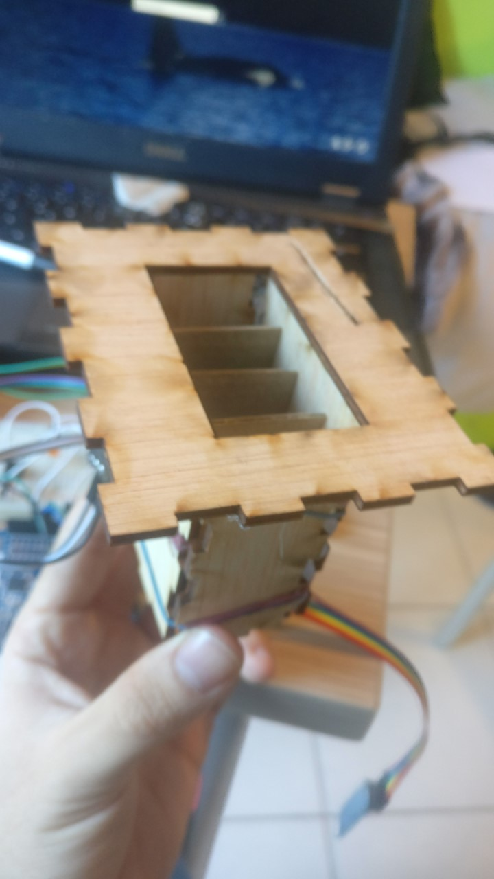
Ressources/11-2.jpg
