lapin06/HT2018/Ressources/11-3.jpg

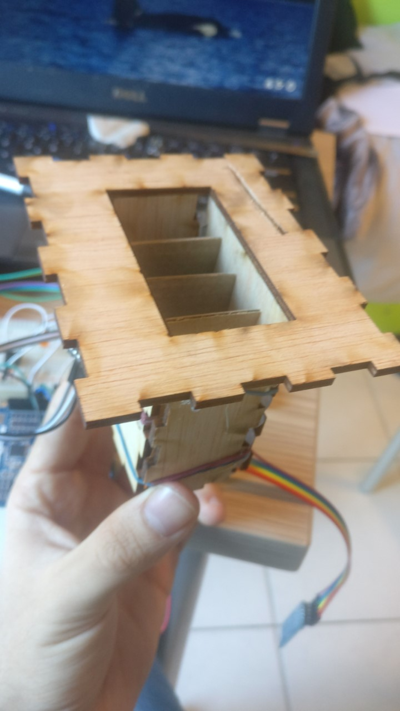
Ressources/11-3.jpg
