lapin06/HT2018/Ressources/11-4.jpg

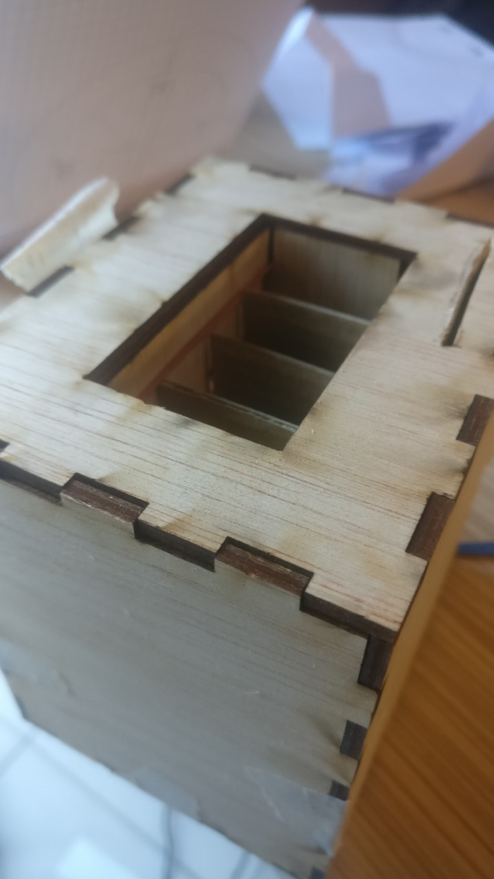
Ressources/11-4.jpg
