lapin06/HT2018/Ressources/11-5.jpg

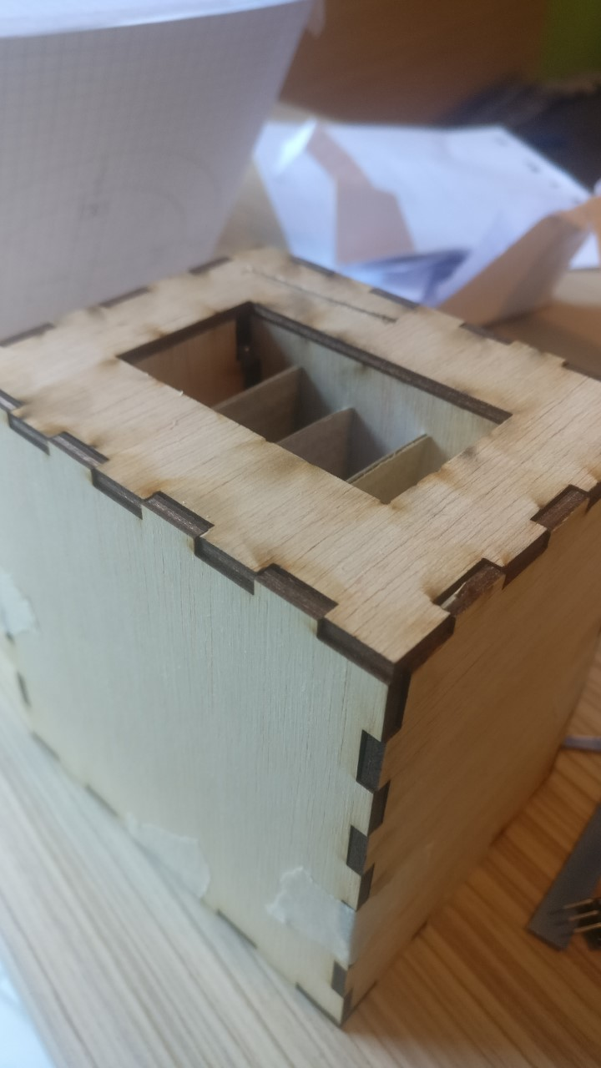
Ressources/11-5.jpg
