lapin06/HT2018/Ressources/11-7.jpg

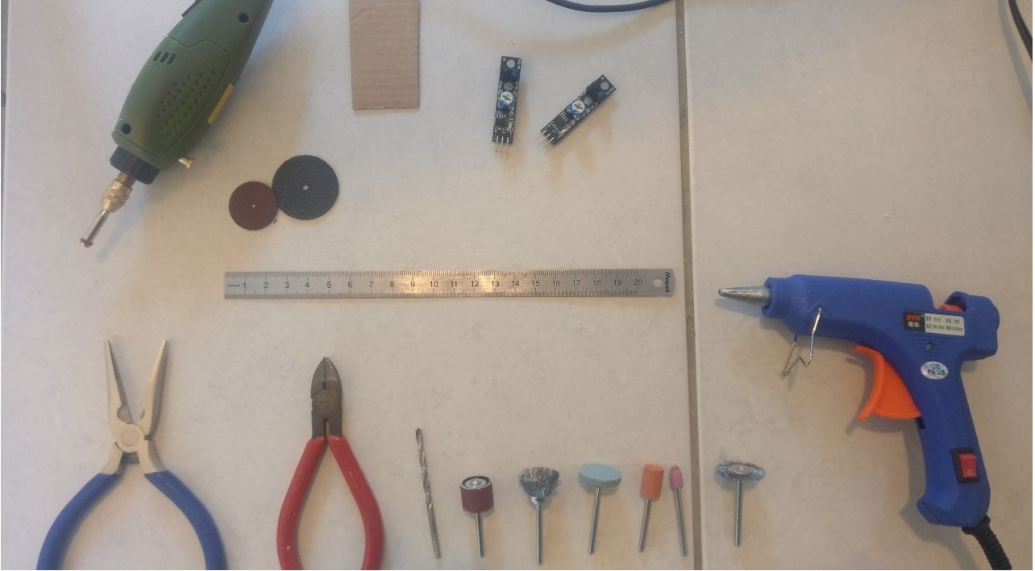
Ressources/11-7.jpg
