lapin06/HT2018/Ressources/11-8.jpg

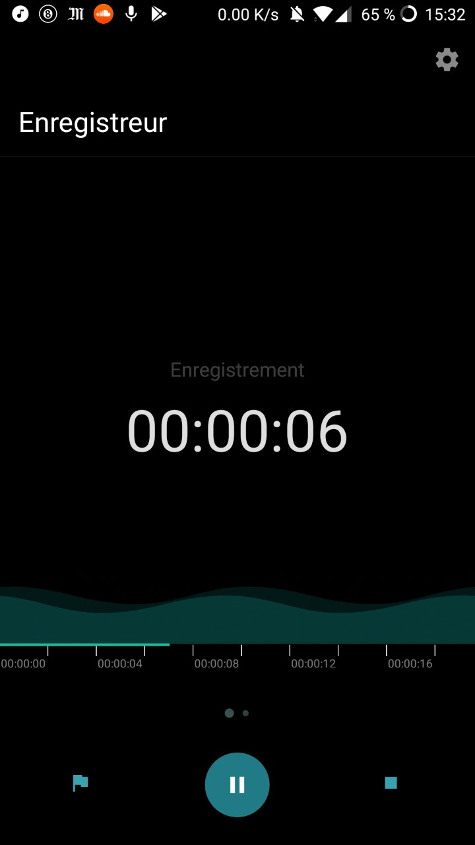
Ressources/11-8.jpg
