lapin06/HT2018/Ressources/20-4.jpg

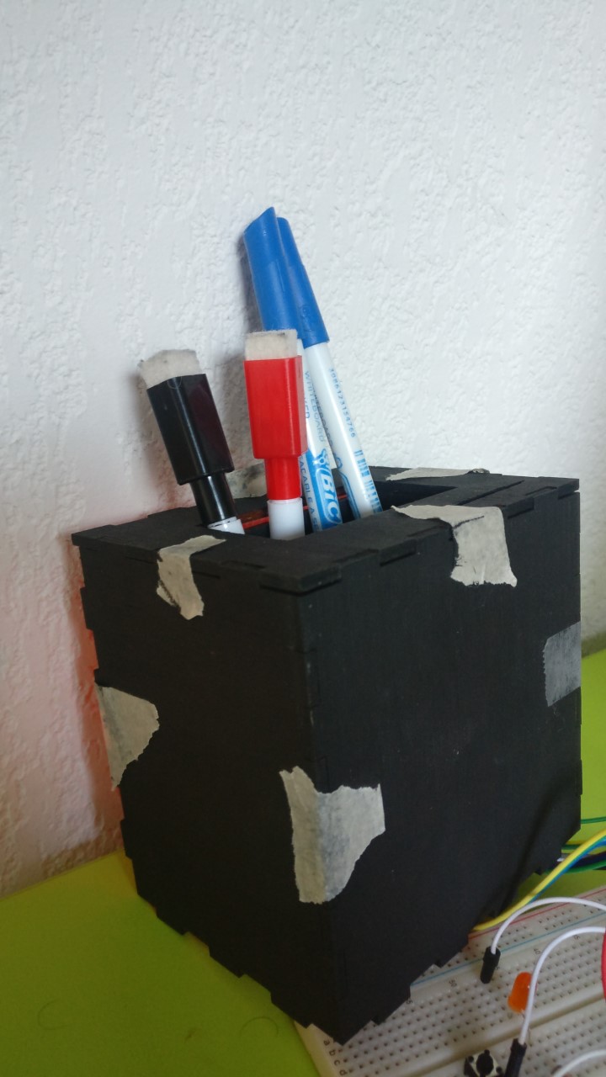
Ressources/20-4.jpg
