lapin06/HT2018/Ressources/boite_feutre_1 et 2.JPG

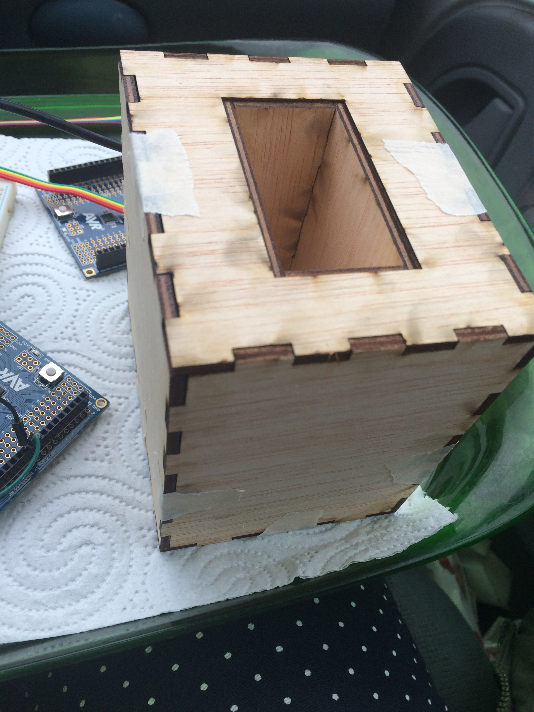
Ressources/boite_feutre_1 et 2.JPG
