lapin06/HT2018/Ressources/boite_feutre_découp_laser.JPG

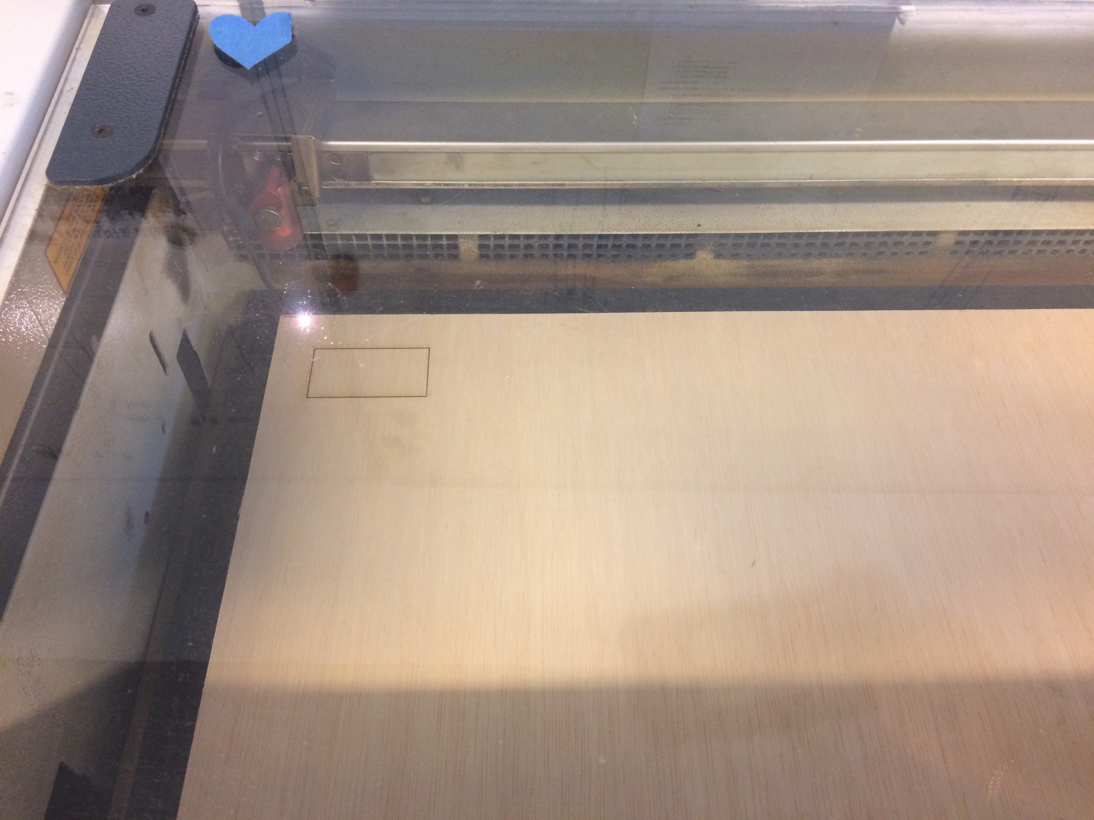
Ressources/boite_feutre_découp_laser.JPG
