lapin06/HT2018/Ressources/C2.jpg

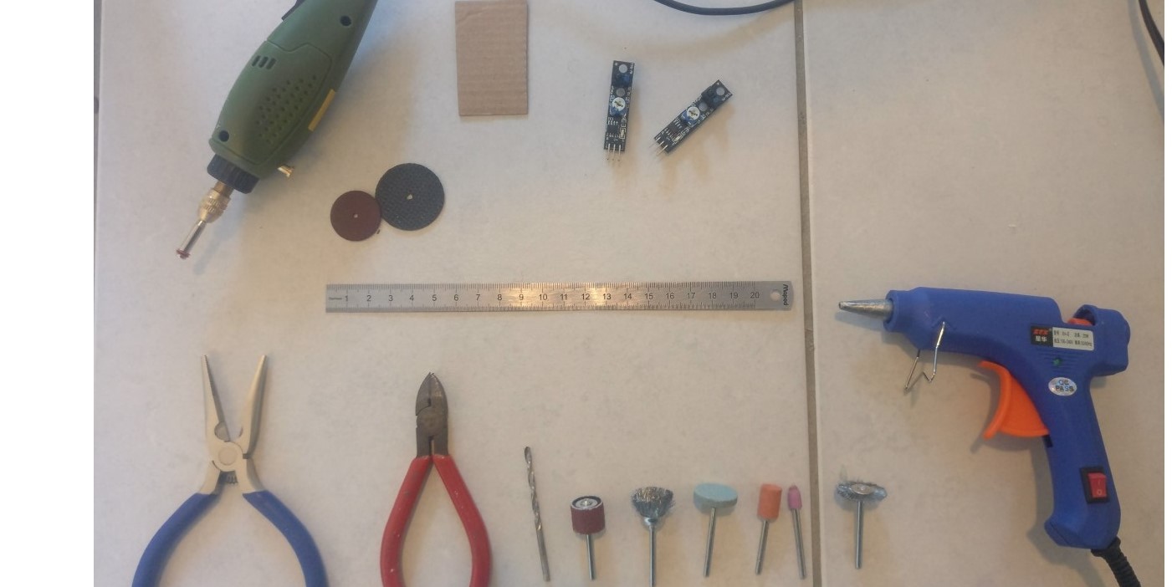
Ressources/C2.jpg
