lapin06/HT2018/Ressources/cablage.jpg

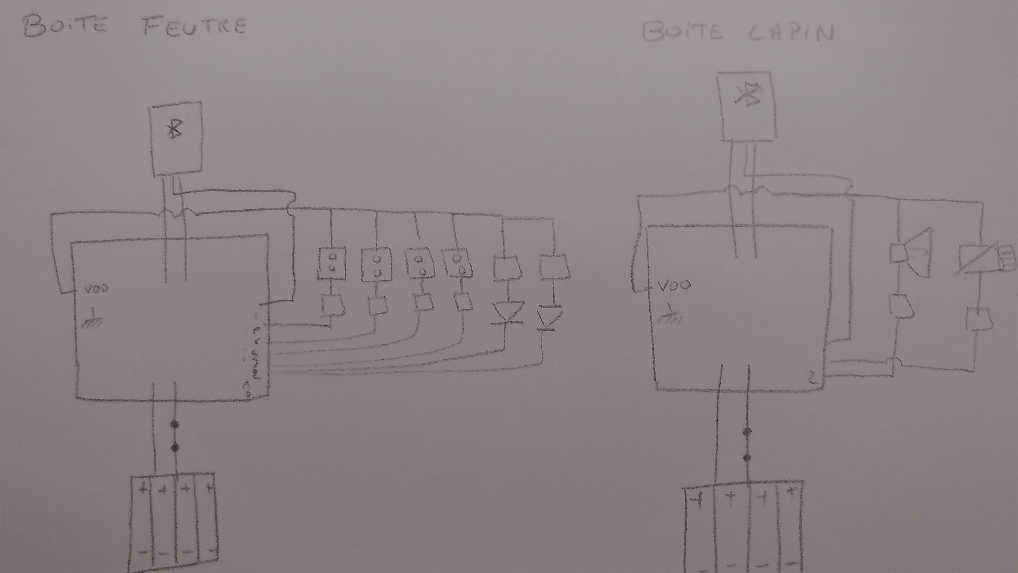
Ressources/cablage.jpg
