lapin06/HT2018/Ressources/helo1.jpg

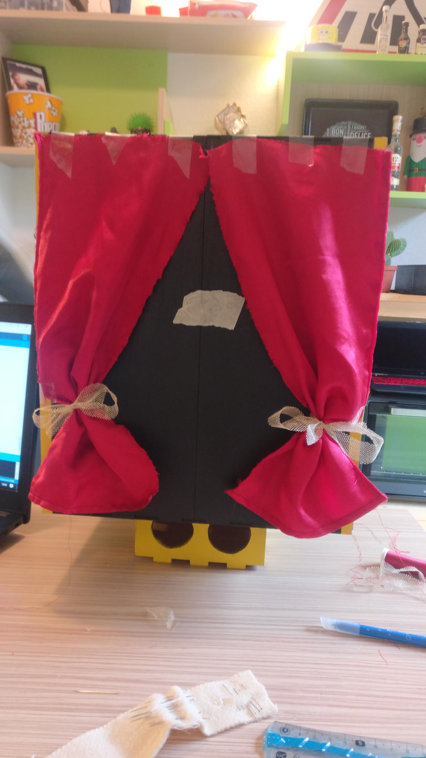
Ressources/helo1.jpg
