lapin06/HT2018/Ressources/helo2.jpg

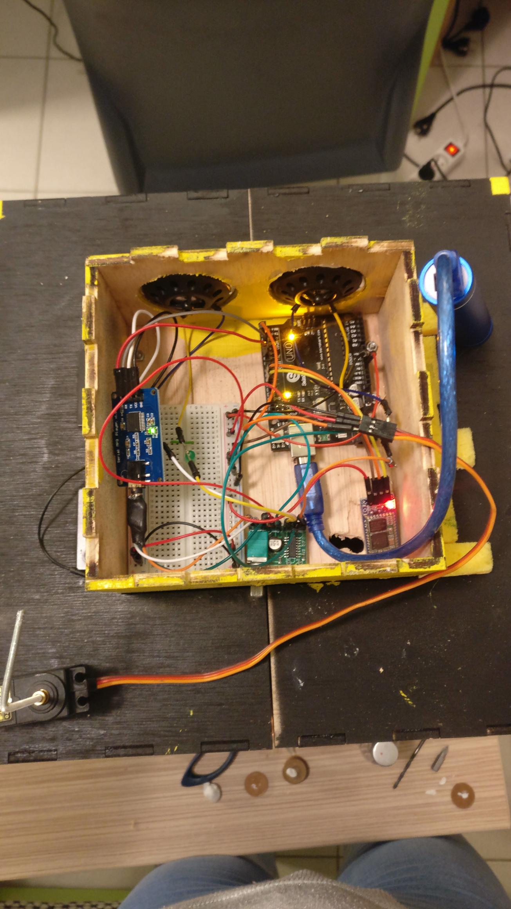
Ressources/helo2.jpg
