lapin06/HT2018/Ressources/helo3.jpg

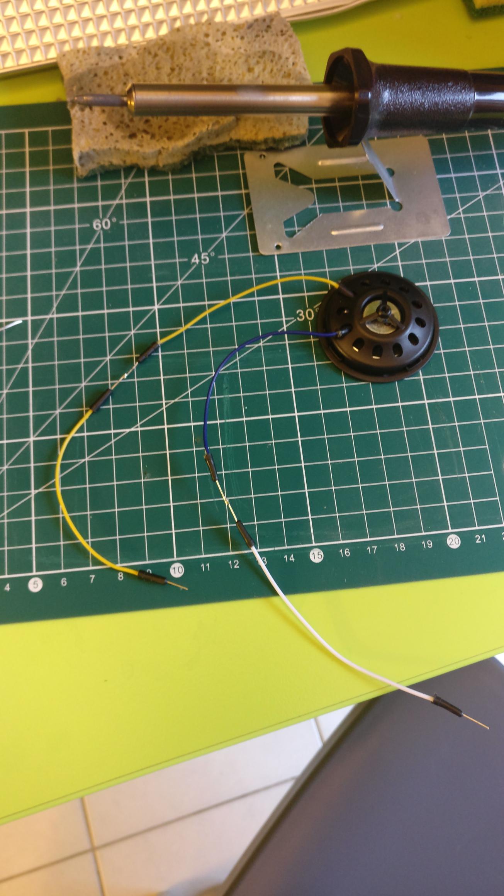
Ressources/helo3.jpg
