lapin06/HT2018/Ressources/helo4.jpg

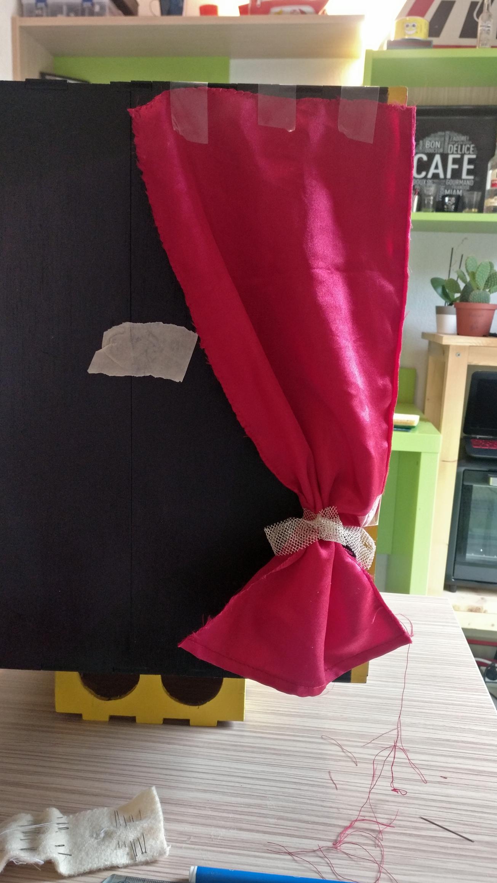
Ressources/helo4.jpg
