lapin06/HT2018/Ressources/IMG_1785.JPG

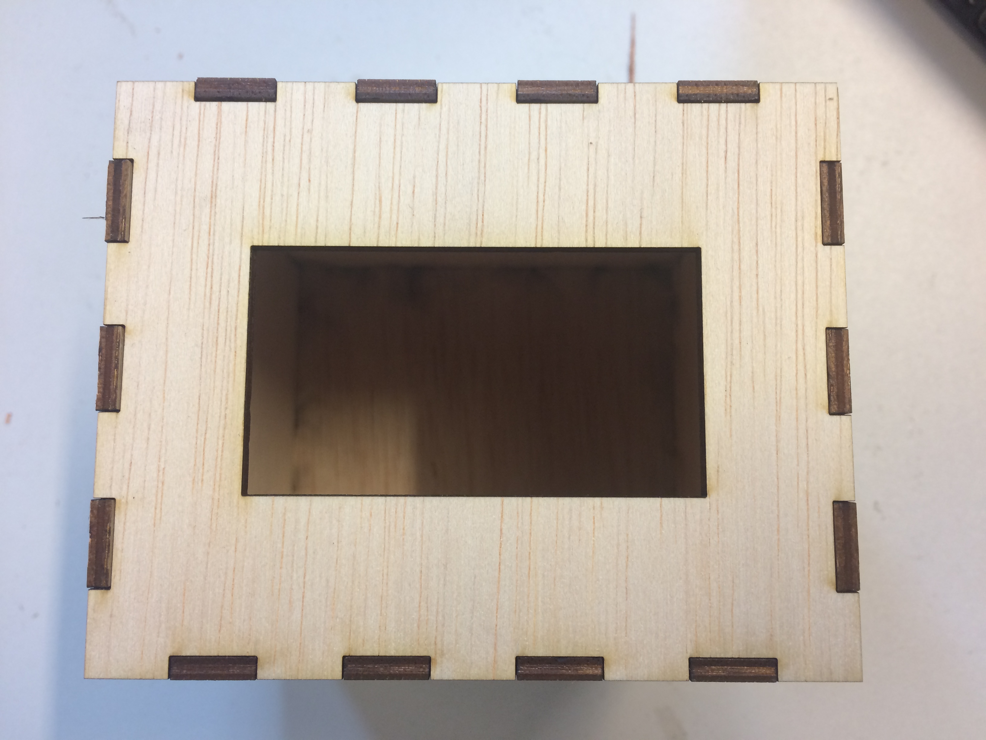
Ressources/IMG_1785.JPG
