lapin06/HT2018/Ressources/Oral1.PNG

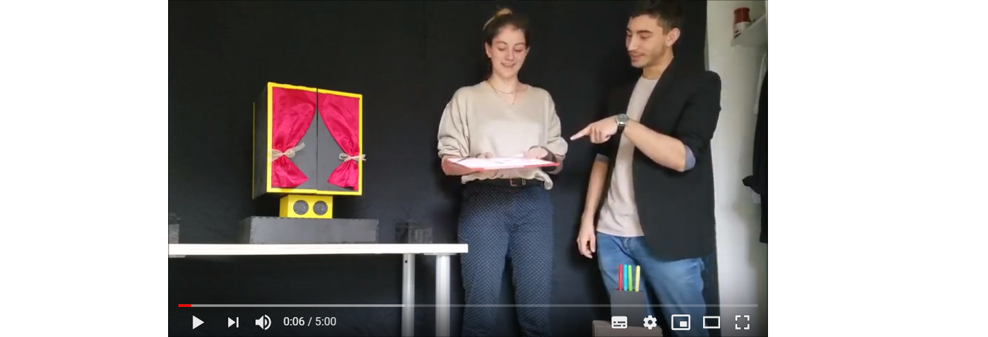
Ressources/Oral1.PNG
