lapin06/HT2018/(commit log)

2018-12-10 Create Rapports de séances
2018-12-10 Rename Rapports de séances to Rapports de séances Théo
2018-12-10 Create Rapport de seance - Héloise
2018-12-10 Rename Rapports de séances Théo to Rapports de séances - Théo
2018-12-10 Rename Rapport de seance - Héloise to Rapport de séances - Héloise
2018-12-10 Rename Rapports de séances - Théo to Rapport de séances - Théo
2018-12-10 Create Rapports de séances/ Rapports - Théo
2019-02-22 Create Rapports de séances Théo
