lapin06/HT2018/Ressources/999.jpg

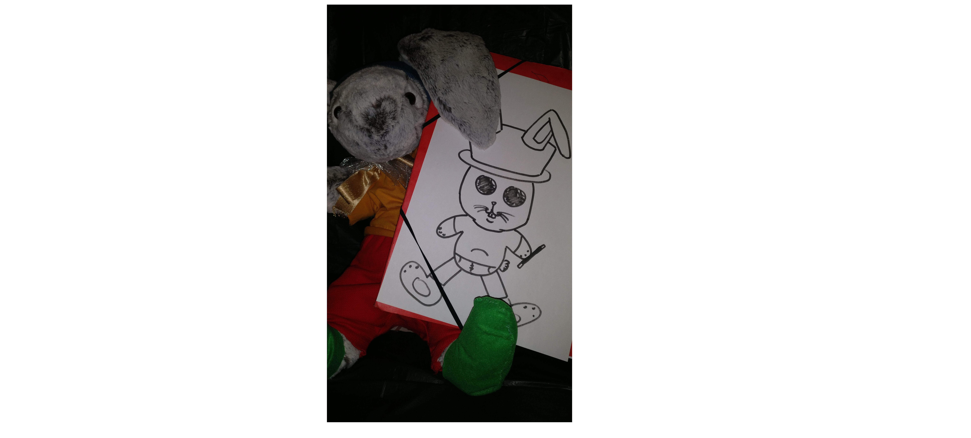
[picture p4: Ressources/999.jpg]
Ressources/999.jpg
